julbouln/stm32_mech_keyboard/README

60% mechanichal keyboard with STM32 controller
