julbouln/stm32_mech_keyboard/hardware/README

Based on https://github.com/Ced67/TCKB_Kicad (https://deskthority.net/workshop-f7/tckb-my-journey-in-the-world-of-stm32-driven-keyboards-60-t14952.html)

Specifications:
- STM32 LQFP48 controller (tested with STM32F042)
- IS31FL3733 LED controller

Bugs/limitations
- USB-MINI B footprint is buggy, there is not solder pad on front layout
