julbouln/stm32_mech_keyboard/hardware/TCKB.kicad_pcb

## KiCad design hardware/TCKB.kicad_pcb (2017-02-14)

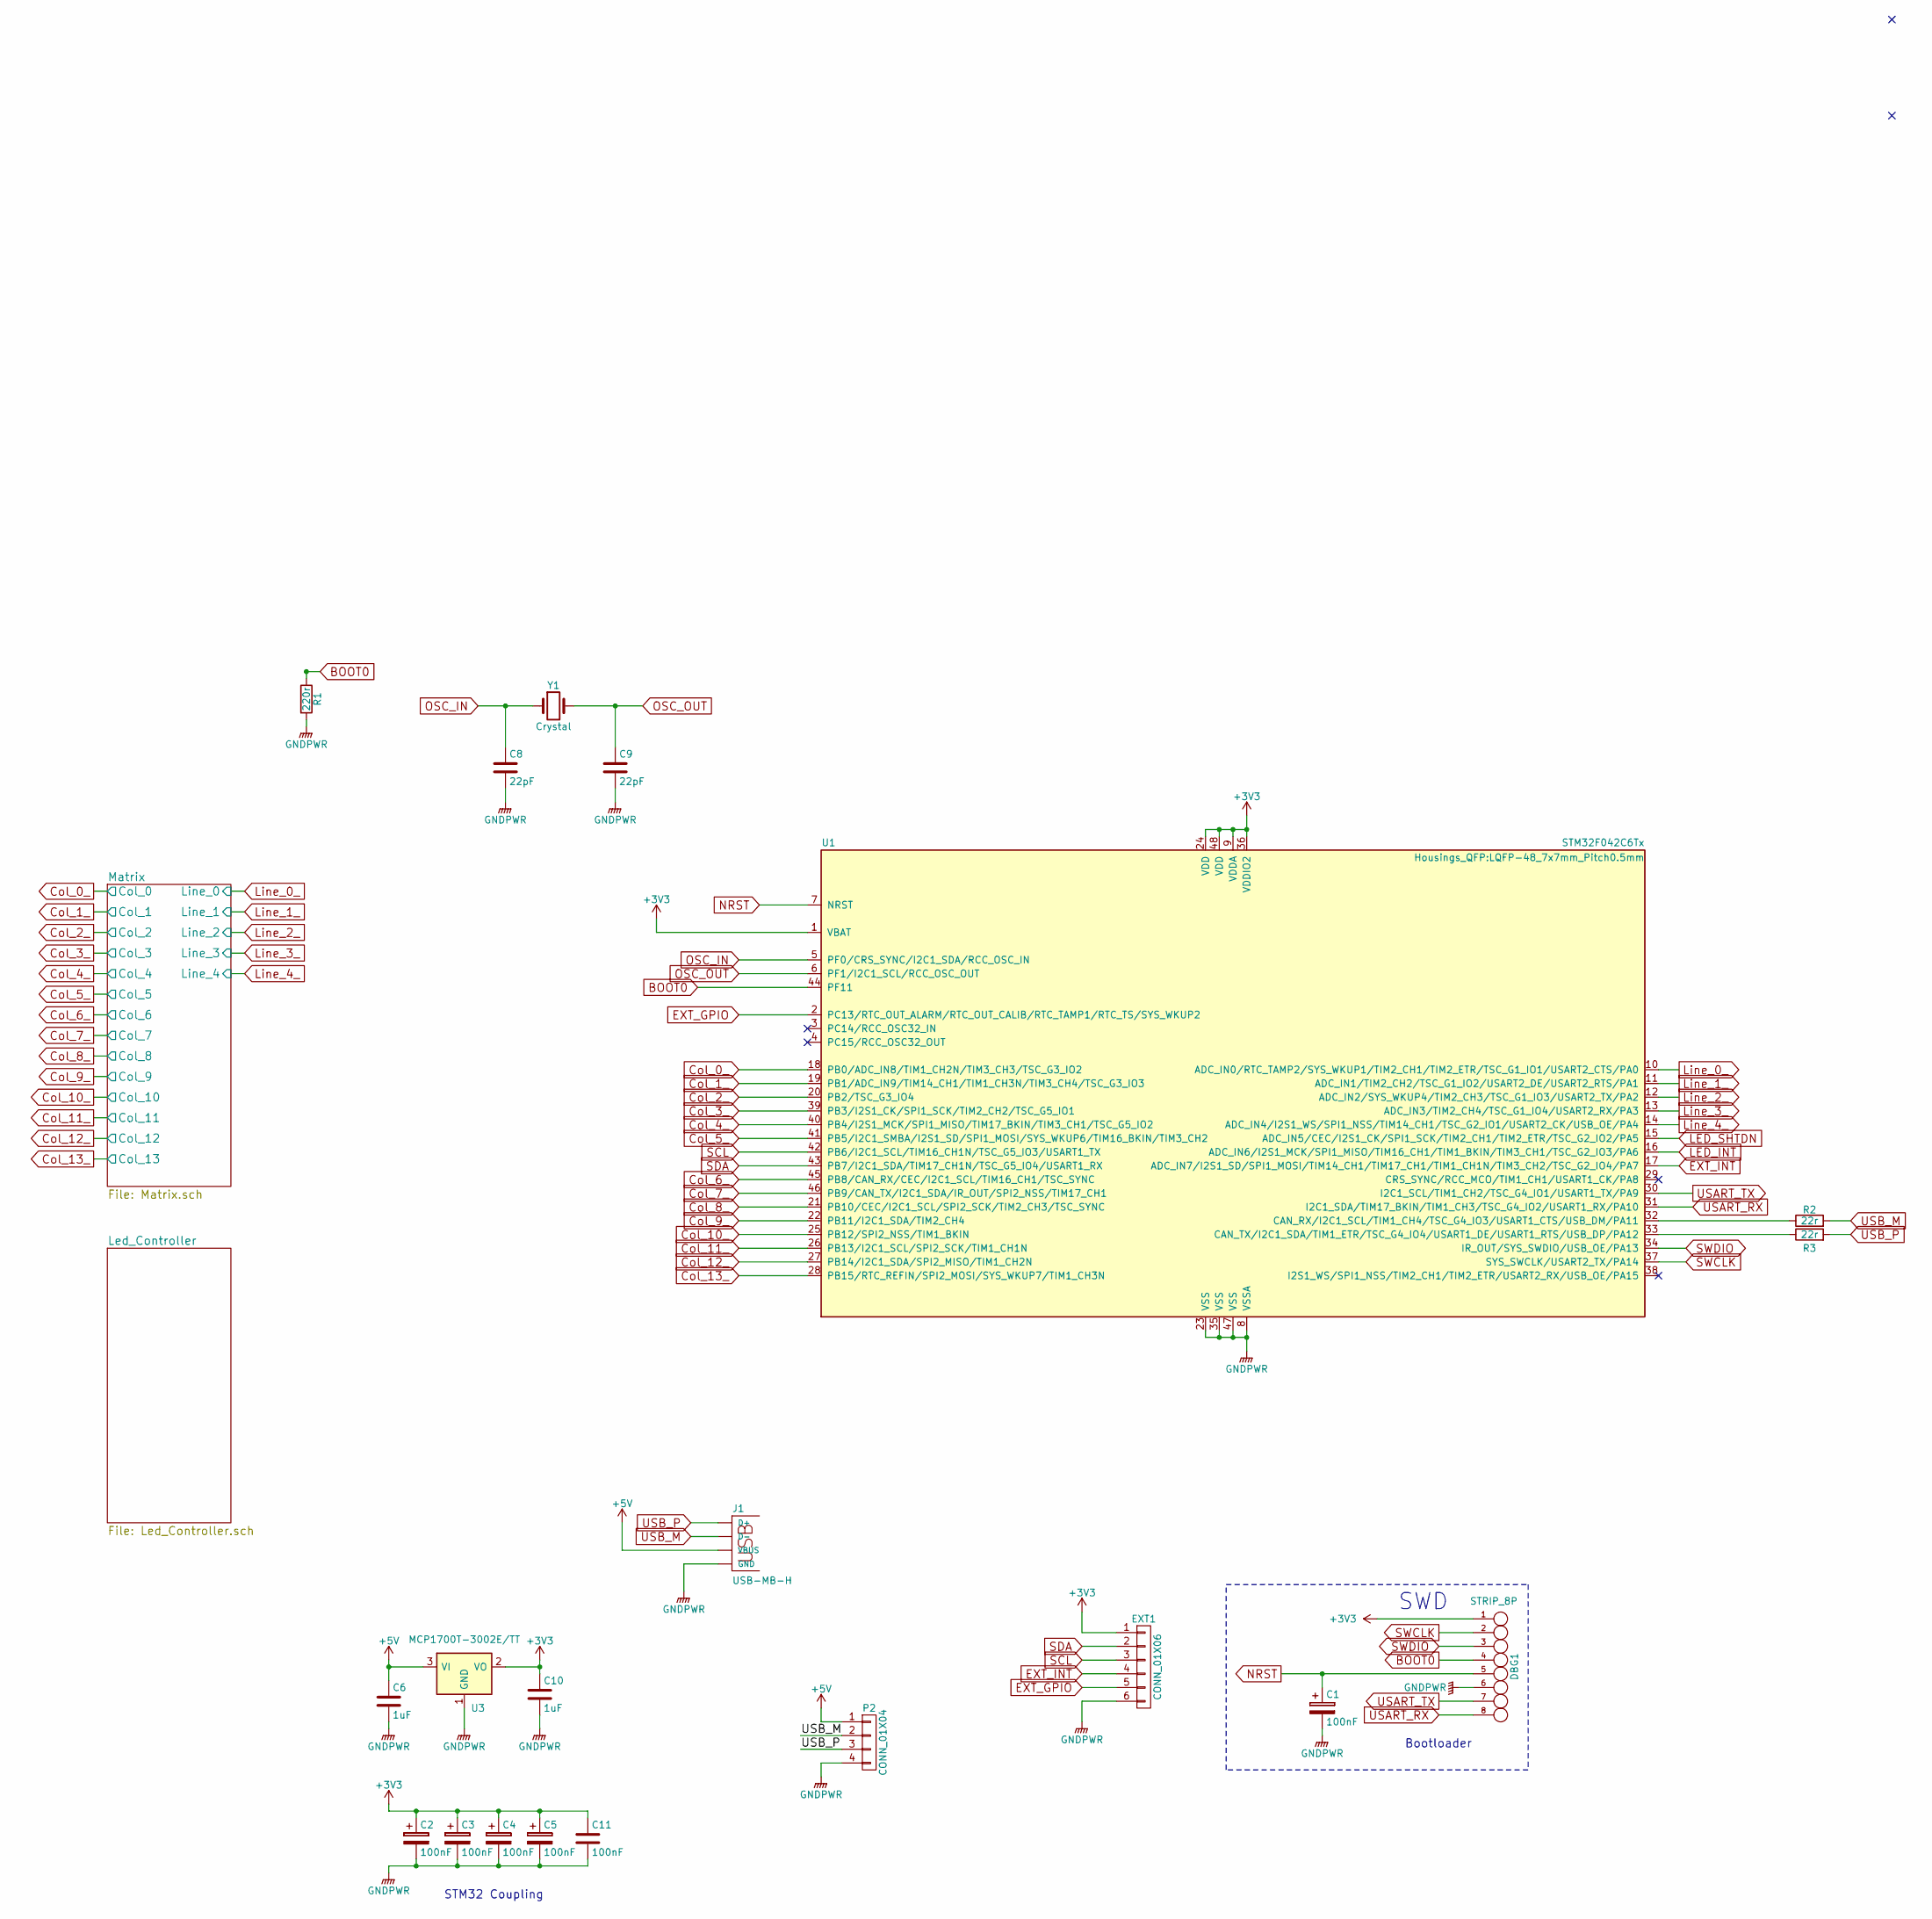
[picture p1: schematic TCKB.sch, TCKB :Tiny Custom KeyBoard (STM32L)]

Parts:
C1, C2, C3, C4, C5, C11: 100nF; C_0603_HandSoldering
C6, C10: 1uF; C_0603_HandSoldering
C8, C9: 22pF; C_0603_HandSoldering
DBG1: STRIP_8P; Pin_Header_Straight_1x08_Pitch2.54mm
EXT1: CONN_01X06; Pin_Header_Straight_1x06_Pitch2.54mm
J1: USB-MB-H
P2: CONN_01X04; Pin_Header_Straight_1x04_Pitch2.54mm
R1: 220r; R_0603_HandSoldering
R2, R3: 22r; R_0603_HandSoldering
U1: STM32F042C6Tx; LQFP-48_7x7mm_Pitch0.5mm
U3: MCP1700T-3002E/TT; SOT-23
Y1: Crystal; ABM3

Connections:
+3V3: C2.1, C3.1, C4.1, C5.1, C10.1, C11.1, DBG1.1, EXT1.1, U1.1 (VBAT), U1.9 (VDDA), U1.24 (VDD), U1.36 (VDDIO2), U1.48 (VDD), U3.2 (VO); also elsewhere on the board
+5V: C6.1, J1.VBUS, P2.1, U3.3 (VI); also elsewhere on the board
BOOT0: DBG1.4, R1.1, U1.44 (PF11)
Col_0_: U1.18 (PB0/ADC_IN8/TIM1_CH2N/TIM3_CH3/TSC_G3_I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); also elsewhere on the board
Col_1_: U1.19 (PB1/ADC_IN9/TIM14_CH1/TIM1_CH3N/TIM3_CH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); also elsewhere on the board
Col_2_: U1.20 (PB2/TSC_G3_IO4); also elsewhere on the board
Col_3_: U1.39 (PB3/I2S1_CK/SPI1_SCK/TIM2_CH2/TSC_G5_IO1); also elsewhere on the board
Col_4_: U1.40 (PB4/I2S1_MCK/SPI1_MISO/TIM17_BKIN/TIM3_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); also elsewhere on the board
Col_5_: U1.41 (PB5/I2C1_SMBA/I2S1_SD/SPI1_MOSI/SYS_WKU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); also elsewhere on the board
Col_6_: U1.45 (PB8/CAN_RX/CEC/I2C1_SCL/TIM16_CH1/TSC_S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); also elsewhere on the board
Col_7_: U1.46 (PB9/CAN_TX/I2C1_SDA/IR_OUT/SPI2_NSS/TIM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); also elsewhere on the board
Col_8_: U1.21 (PB10/CEC/I2C1_SCL/SPI2_SCK/TIM2_CH3/TSC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); also elsewhere on the board
Col_9_: U1.22 (PB11/I2C1_SDA/TIM2_CH4); also elsewhere on the board
Col_10_: U1.25 (PB12/SPI2_NSS/TIM1_BKIN); also elsewhere on the board
Col_11_: U1.26 (PB13/I2C1_SCL/SPI2_SCK/TIM1_CH1N); also elsewhere on the board
Col_12_: U1.27 (PB14/I2C1_SDA/SPI2_MISO/TIM1_CH2N); also elsewhere on the board
Col_13_: U1.28 (PB15/RTC_REFIN/SPI2_MOSI/SYS_WKUP7/TIM1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); also elsewhere on the board
EXT_GPIO: EXT1.5, U1.2 (PC13/RTC_OUT_ALARM/RTC_OUT_CALIB/RTC_TA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)
EXT_INT: EXT1.4, U1.17 (ADC_IN7/I2S1_SD/SPI1_MOSI/TIM14_CH1/TIM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)
GNDPWR: C1.2, C2.2, C3.2, C4.2, C5.2, C6.2, C8.2, C9.2, C10.2, C11.2, DBG1.6, EXT1.6, J1.GND, P2.4, R1.2, U1.8 (VSSA), U1.23 (VSS), U1.35 (VSS), U1.47 (VSS), U3.1 (GND); also elsewhere on the board
LED_INT: U1.16 (ADC_IN6/I2S1_MCK/SPI1_MISO/TIM16_CH1/TI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); also elsewhere on the board
LED_SHTDN: U1.15 (ADC_IN5/CEC/I2S1_CK/SPI1_SCK/TIM2_CH1/T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); also elsewhere on the board
Line_0_: U1.10 (ADC_IN0/RTC_TAMP2/SYS_WKUP1/TIM2_CH1/TI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); also elsewhere on the board
Line_1_: U1.11 (ADC_IN1/TIM2_CH2/TSC_G1_IO2/USART2_DE/U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); also elsewhere on the board
Line_2_: U1.12 (ADC_IN2/SYS_WKUP4/TIM2_CH3/TSC_G1_IO3/U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); also elsewhere on the board
Line_3_: U1.13 (ADC_IN3/TIM2_CH4/TSC_G1_IO4/USART2_RX/P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); also elsewhere on the board
Line_4_: U1.14 (ADC_IN4/I2S1_WS/SPI1_NSS/TIM14_CH1/TSC_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); also elsewhere on the board
NRST: C1.1, DBG1.5, U1.7 (NRST)
unnamed: R2.1, U1.32 (CAN_RX/I2C1_SCL/TIM1_CH4/TSC_G4_IO3/USA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)
unnamed: R3.1, U1.33 (CAN_TX/I2C1_SDA/TIM1_ETR/TSC_G4_IO4/USA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)
OSC_IN: C8.1, U1.5 (PF0/CRS_SYNC/I2C1_SDA/RCC_OSC_IN), Y1.1
OSC_OUT: C9.1, U1.6 (PF1/I2C1_SCL/RCC_OSC_OUT), Y1.2
SCL: EXT1.3, U1.42 (PB6/I2C1_SCL/TIM16_CH1N/TSC_G5_IO3/USAR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); also elsewhere on the board
SDA: EXT1.2, U1.43 (PB7/I2C1_SDA/TIM17_CH1N/TSC_G5_IO4/USAR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); also elsewhere on the board
SWCLK: DBG1.2, U1.37 (SYS_SWCLK/USART2_TX/PA14)
SWDIO: DBG1.3, U1.34 (IR_OUT/SYS_SWDIO/USB_OE/PA13)
USART_RX: DBG1.8, U1.31 (I2C1_SDA/TIM17_BKIN/TIM1_CH3/TSC_G4_IO2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)
USART_TX: DBG1.7, U1.30 (I2C1_SCL/TIM1_CH2/TSC_G4_IO1/USART1_TX/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)
USB_M: J1.D-, P2.2, R2.2
USB_P: J1.D+, P2.3, R3.2

Notes on the sheet:
SWD
STM32 Coupling
Bootloader

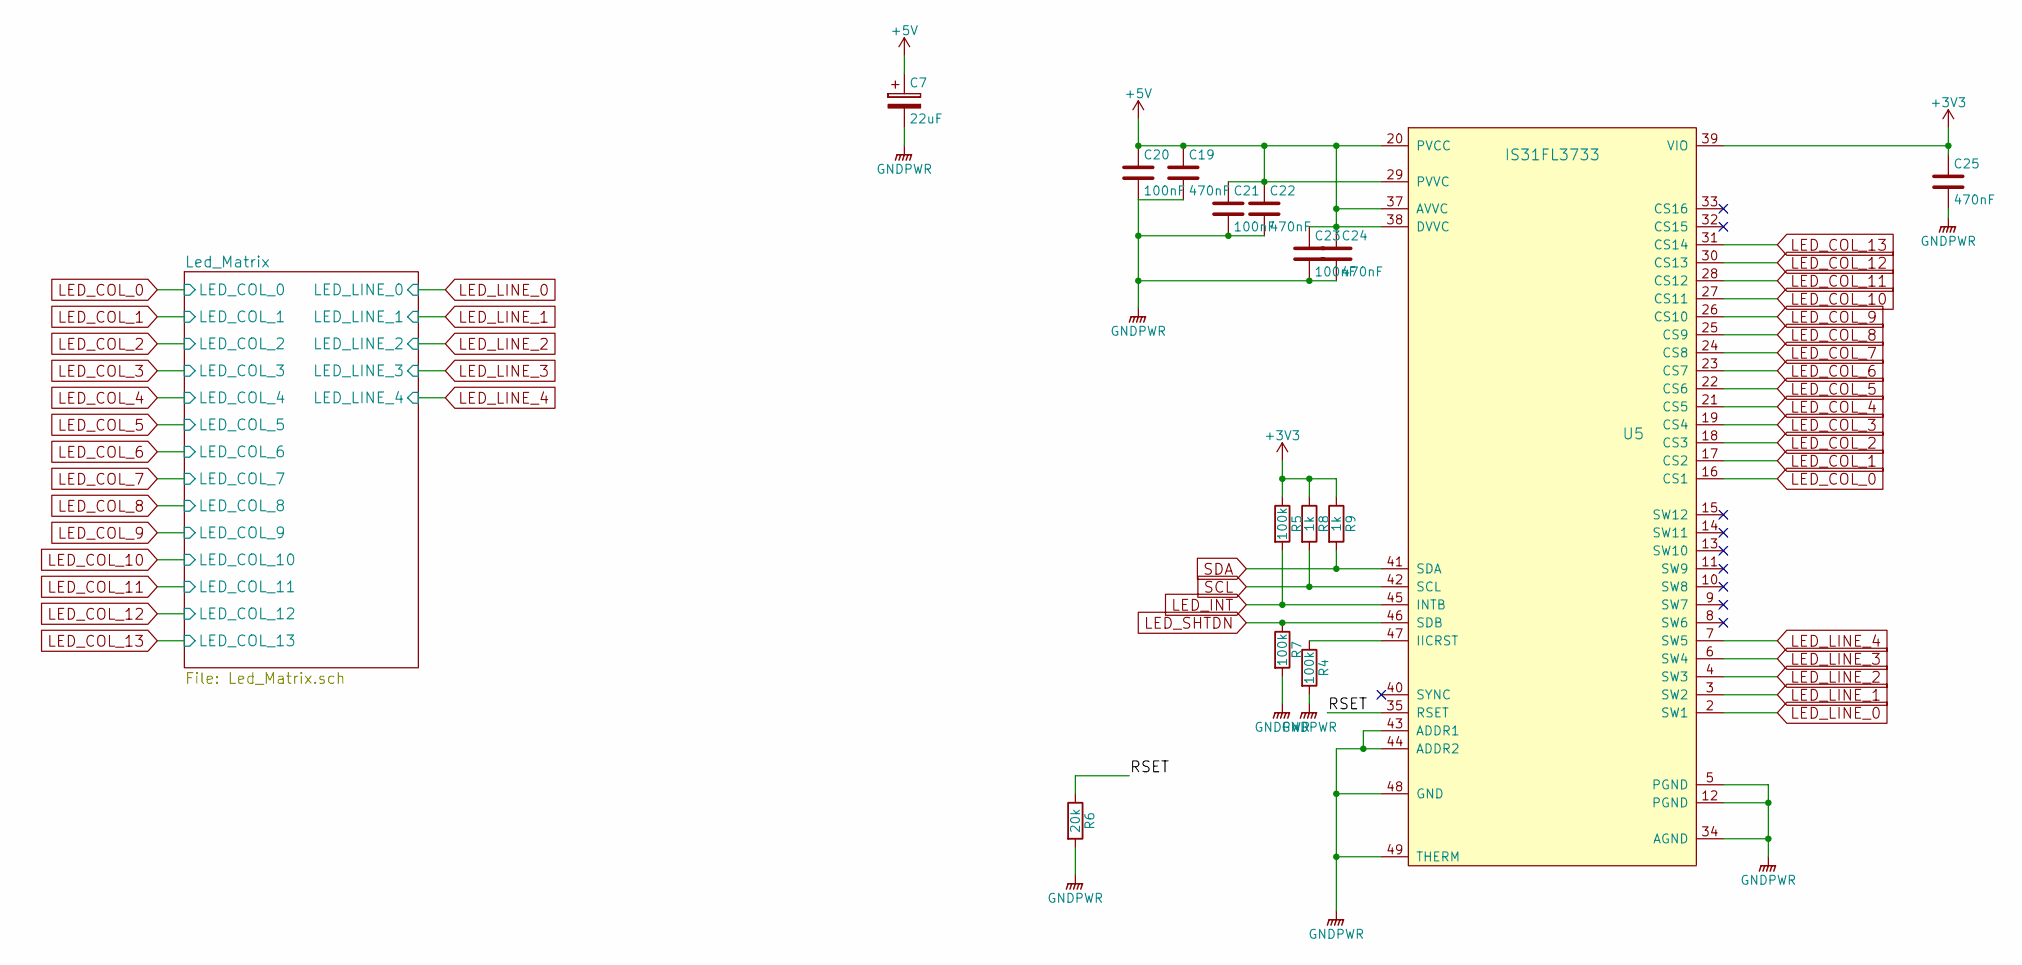
[picture p2: schematic Led_Controller.sch, TCKB :Tiny Custom KeyBoard (STM32L)]

Parts:
C7: 22uF; C_1206_HandSoldering
C19, C22, C24, C25: 470nF; C_0603_HandSoldering
C20, C21, C23: 100nF; C_0603_HandSoldering
R4, R5, R7: 100k; R_0603_HandSoldering
R6: 20k; R_0603_HandSoldering
R8, R9: 1k; R_0603_HandSoldering
U5: IS31FL3733; UQFN-48-1EP_6x6mm_Pitch0.4mm

Connections:
+3V3: C25.1, R5.1, R8.1, R9.1, U5.39 (VIO); also elsewhere on the board
+5V: C7.1, C19.1, C20.1, C21.1, C22.1, C23.1, C24.1, U5.20 (PVCC), U5.29 (PVVC), U5.37 (AVVC), U5.38 (DVVC); also elsewhere on the board
/Led_Controller/RSET: R6.1, U5.35 (RSET)
GNDPWR: C7.2, C19.2, C20.2, C21.2, C22.2, C23.2, C24.2, C25.2, R4.2, R6.2, R7.2, U5.5 (PGND), U5.12 (PGND), U5.34 (AGND), U5.43 (ADDR1), U5.44 (ADDR2), U5.48 (GND), U5.49 (THERM); also elsewhere on the board
LED_COL_0: U5.16 (CS1); also elsewhere on the board
LED_COL_1: U5.17 (CS2); also elsewhere on the board
LED_COL_2: U5.18 (CS3); also elsewhere on the board
LED_COL_3: U5.19 (CS4); also elsewhere on the board
LED_COL_4: U5.21 (CS5); also elsewhere on the board
LED_COL_5: U5.22 (CS6); also elsewhere on the board
LED_COL_6: U5.23 (CS7); also elsewhere on the board
LED_COL_7: U5.24 (CS8); also elsewhere on the board
LED_COL_8: U5.25 (CS9); also elsewhere on the board
LED_COL_9: U5.26 (CS10); also elsewhere on the board
LED_COL_10: U5.27 (CS11); also elsewhere on the board
LED_COL_11: U5.28 (CS12); also elsewhere on the board
LED_COL_12: U5.30 (CS13); also elsewhere on the board
LED_COL_13: U5.31 (CS14); also elsewhere on the board
LED_INT: R5.2, U5.45 (INTB); also elsewhere on the board
LED_LINE_0: U5.2 (SW1); also elsewhere on the board
LED_LINE_1: U5.3 (SW2); also elsewhere on the board
LED_LINE_2: U5.4 (SW3); also elsewhere on the board
LED_LINE_3: U5.6 (SW4); also elsewhere on the board
LED_LINE_4: U5.7 (SW5); also elsewhere on the board
LED_SHTDN: R7.1, U5.46 (SDB); also elsewhere on the board
unnamed: R4.1, U5.47 (IICRST)
SCL: R8.2, U5.42 (SCL); also elsewhere on the board
SDA: R9.2, U5.41 (SDA); also elsewhere on the board

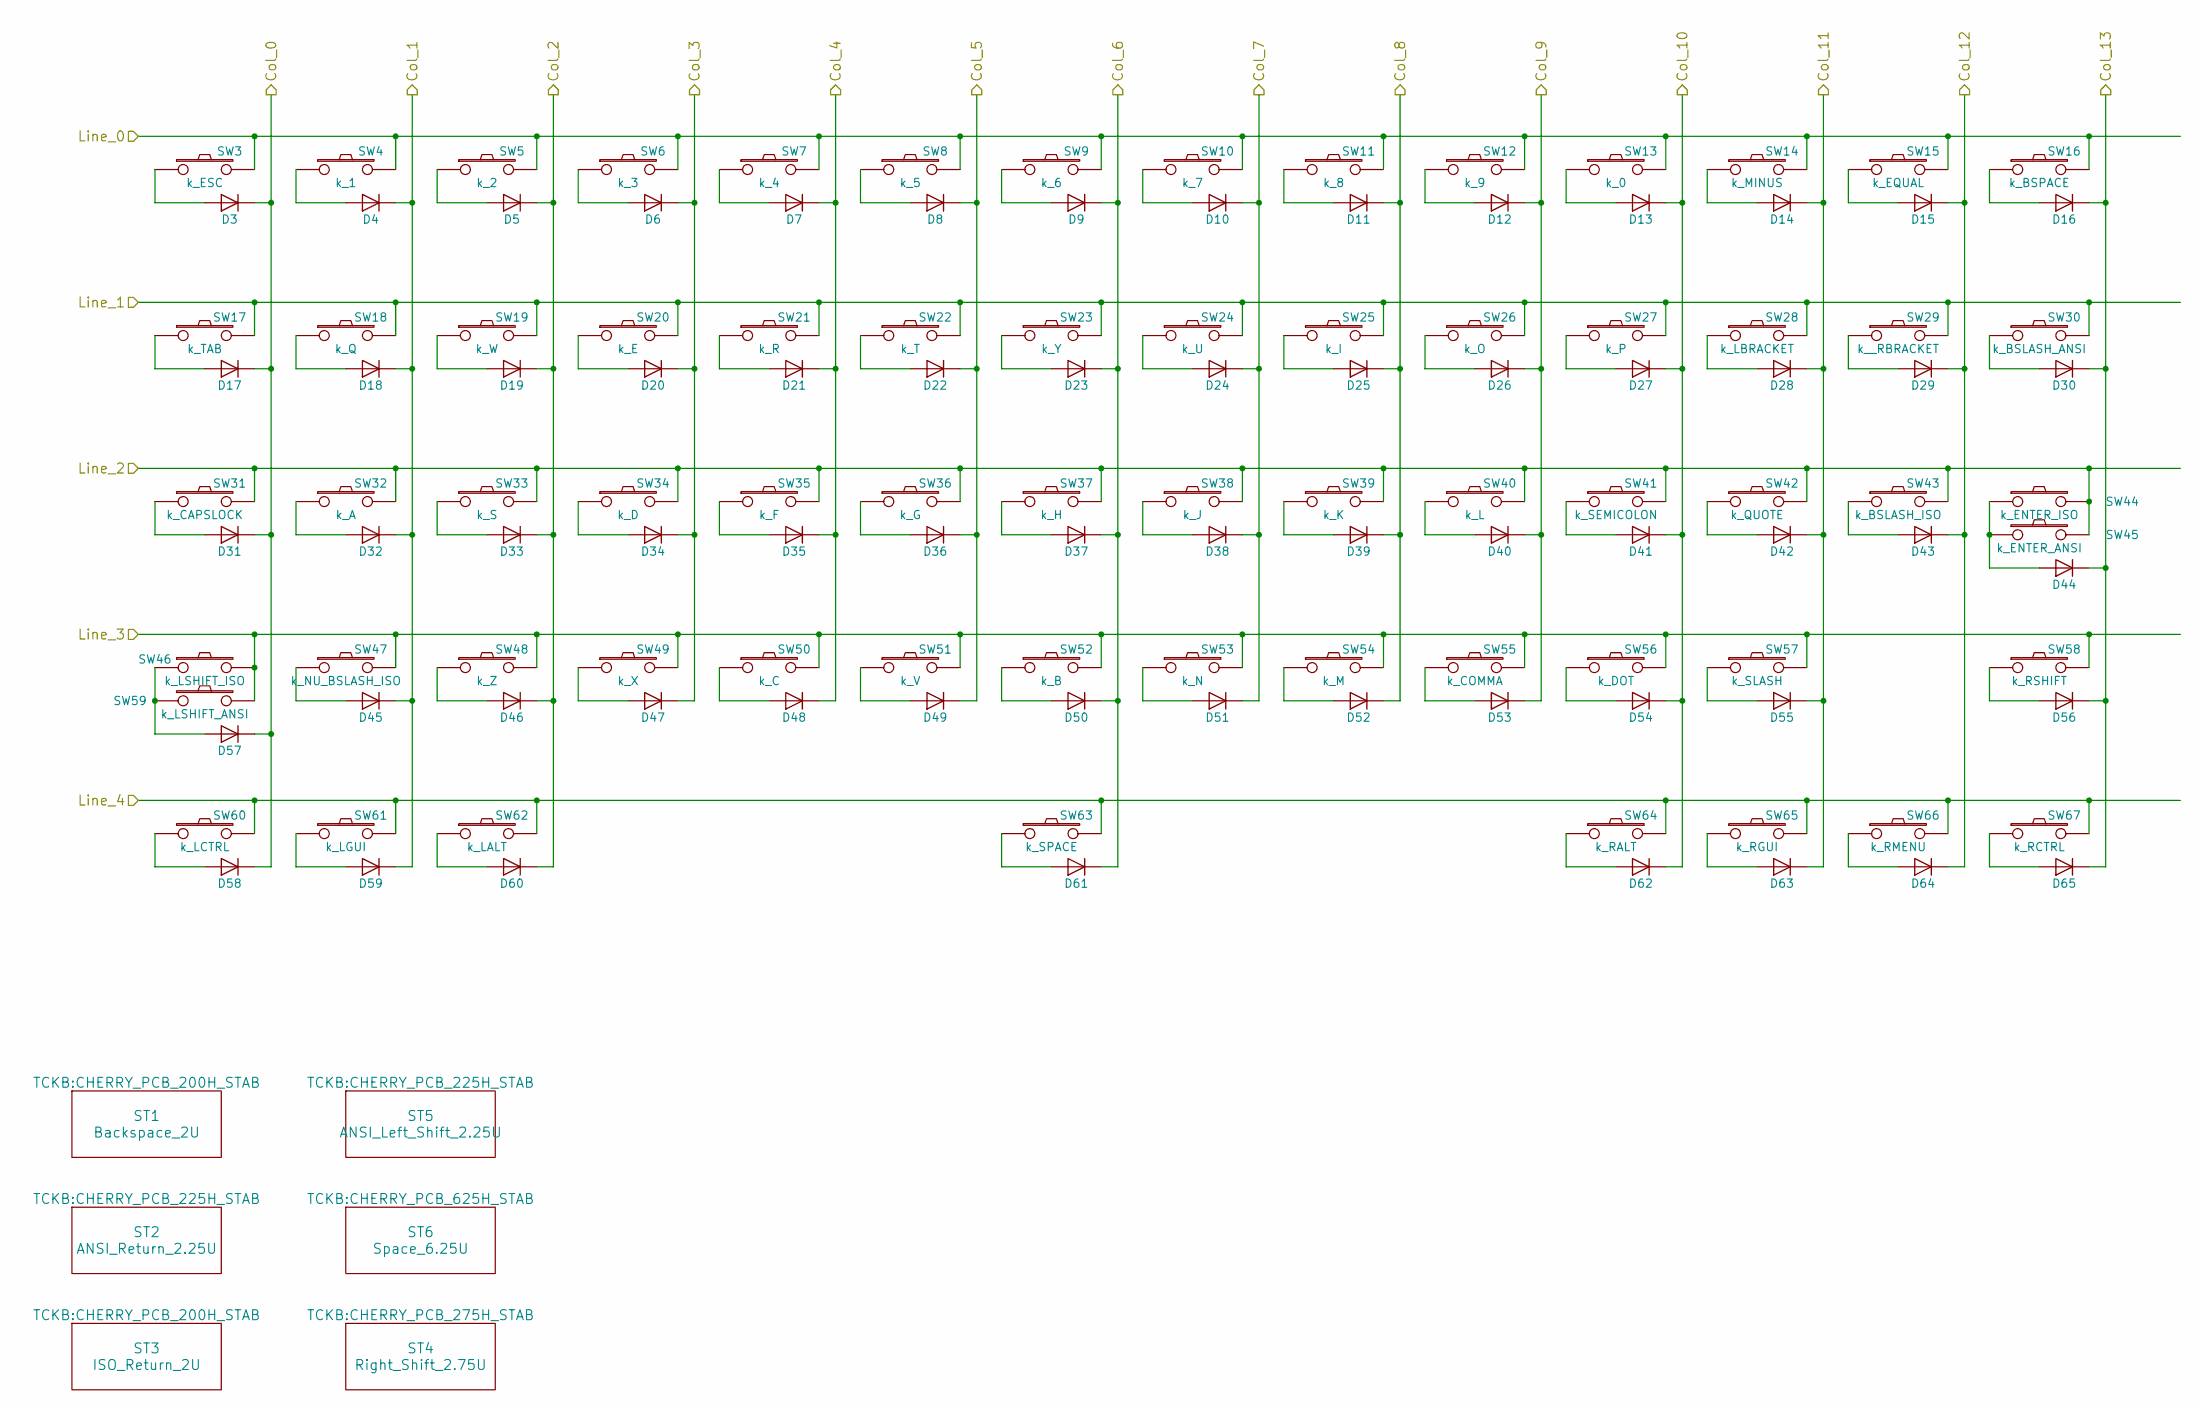
[picture p3: schematic Matrix.sch, TCKB :Tiny Custom KeyBoard (STM32L)]

Parts:
D3, D4, D5, D6, D7, D8, D9, D10, D11, D12, D13, D14, D15, D16, D17, D18, D19, D20, D21, D22, D23, D24, D25, D26, D27, D28, D29, D30, D31, D32, D33, D34, D35, D36, D37, D38, D39, D40, D41, D42, D43, D44, D45, D46, D47, D48, D49, D50, D51, D52, D53, D54, D55, D56, D57, D58, D59, D60, D61, D62, D63, D64, D65: 1N4148; MiniMELF_2mm
ST1: Backspace_2U; CHERRY_PCB_200H_STAB
ST2: ANSI_Return_2.25U; CHERRY_PCB_225H_STAB
ST3: ISO_Return_2U; CHERRY_PCB_200H_STAB
ST4: Right_Shift_2.75U; CHERRY_PCB_275H_STAB
ST5: ANSI_Left_Shift_2.25U; CHERRY_PCB_225H_STAB
ST6: Space_6.25U; CHERRY_PCB_625H_STAB
SW3: k_ESC; CHERRY_PCB_100H
SW4: k_1; CHERRY_PCB_100H
SW5: k_2; CHERRY_PCB_100H
SW6: k_3; CHERRY_PCB_100H
SW7: k_4; CHERRY_PCB_100H
SW8: k_5; CHERRY_PCB_100H
SW9: k_6; CHERRY_PCB_100H
SW10: k_7; CHERRY_PCB_100H
SW11: k_8; CHERRY_PCB_100H
SW12: k_9; CHERRY_PCB_100H
SW13: k_0; CHERRY_PCB_100H
SW14: k_MINUS; CHERRY_PCB_100H
SW15: k_EQUAL; CHERRY_PCB_100H
SW16: k_BSPACE; CHERRY_PCB_200H_SW
SW17: k_TAB; CHERRY_PCB_150H
SW18: k_Q; CHERRY_PCB_100H
SW19: k_W; CHERRY_PCB_100H
SW20: k_E; CHERRY_PCB_100H
SW21: k_R; CHERRY_PCB_100H
SW22: k_T; CHERRY_PCB_100H
SW23: k_Y; CHERRY_PCB_100H
SW24: k_U; CHERRY_PCB_100H
SW25: k_I; CHERRY_PCB_100H
SW26: k_O; CHERRY_PCB_100H
SW27: k_P; CHERRY_PCB_100H
SW28: k_LBRACKET; CHERRY_PCB_100H
SW29: k__RBRACKET; CHERRY_PCB_100H
SW30: k_BSLASH_ANSI; CHERRY_PCB_150H
SW31: k_CAPSLOCK; CHERRY_PCB_175H
SW32: k_A; CHERRY_PCB_100H
SW33: k_S; CHERRY_PCB_100H
SW34: k_D; CHERRY_PCB_100H
SW35: k_F; CHERRY_PCB_100H
SW36: k_G; CHERRY_PCB_100H
SW37: k_H; CHERRY_PCB_100H
SW38: k_J; CHERRY_PCB_100H
SW39: k_K; CHERRY_PCB_100H
SW40: k_L; CHERRY_PCB_100H
SW41: k_SEMICOLON; CHERRY_PCB_100H
SW42: k_QUOTE; CHERRY_PCB_100H
SW43: k_BSLASH_ISO; CHERRY_PCB_100H
SW44: k_ENTER_ISO; CHERRY_PCB_200H_SW
SW45: k_ENTER_ANSI; CHERRY_PCB_225H_SW
SW46: k_LSHIFT_ISO; CHERRY_PCB_125H
SW47: k_NU_BSLASH_ISO; CHERRY_PCB_100H
SW48: k_Z; CHERRY_PCB_100H
SW49: k_X; CHERRY_PCB_100H
SW50: k_C; CHERRY_PCB_100H
SW51: k_V; CHERRY_PCB_100H
SW52: k_B; CHERRY_PCB_100H
SW53: k_N; CHERRY_PCB_100H
SW54: k_M; CHERRY_PCB_100H
SW55: k_COMMA; CHERRY_PCB_100H
SW56: k_DOT; CHERRY_PCB_100H
SW57: k_SLASH; CHERRY_PCB_100H
SW58: k_RSHIFT; CHERRY_PCB_275H_SW
SW59: k_LSHIFT_ANSI; CHERRY_PCB_225H_SW
SW60: k_LCTRL; CHERRY_PCB_125H
SW61: k_LGUI; CHERRY_PCB_125H
SW62: k_LALT; CHERRY_PCB_125H
SW63: k_SPACE; CHERRY_PCB_625H_SW
SW64: k_RALT; CHERRY_PCB_125H
SW65: k_RGUI; CHERRY_PCB_125H
SW66: k_RMENU; CHERRY_PCB_125H
SW67: k_RCTRL; CHERRY_PCB_125H

Connections:
Col_0_: D3.1 (K), D17.1 (K), D31.1 (K), D57.1 (K), D58.1 (K); also elsewhere on the board
Col_1_: D4.1 (K), D18.1 (K), D32.1 (K), D45.1 (K), D59.1 (K); also elsewhere on the board
Col_2_: D5.1 (K), D19.1 (K), D33.1 (K), D46.1 (K), D60.1 (K); also elsewhere on the board
Col_3_: D6.1 (K), D20.1 (K), D34.1 (K), D47.1 (K); also elsewhere on the board
Col_4_: D7.1 (K), D21.1 (K), D35.1 (K), D48.1 (K); also elsewhere on the board
Col_5_: D8.1 (K), D22.1 (K), D36.1 (K), D49.1 (K); also elsewhere on the board
Col_6_: D9.1 (K), D23.1 (K), D37.1 (K), D50.1 (K), D61.1 (K); also elsewhere on the board
Col_7_: D10.1 (K), D24.1 (K), D38.1 (K), D51.1 (K); also elsewhere on the board
Col_8_: D11.1 (K), D25.1 (K), D39.1 (K), D52.1 (K); also elsewhere on the board
Col_9_: D12.1 (K), D26.1 (K), D40.1 (K), D53.1 (K); also elsewhere on the board
Col_10_: D13.1 (K), D27.1 (K), D41.1 (K), D54.1 (K), D62.1 (K); also elsewhere on the board
Col_11_: D14.1 (K), D28.1 (K), D42.1 (K), D55.1 (K), D63.1 (K); also elsewhere on the board
Col_12_: D15.1 (K), D29.1 (K), D43.1 (K), D64.1 (K); also elsewhere on the board
Col_13_: D16.1 (K), D30.1 (K), D44.1 (K), D56.1 (K), D65.1 (K); also elsewhere on the board
Line_0_: SW3.2, SW4.2, SW5.2, SW6.2, SW7.2, SW8.2, SW9.2, SW10.2, SW11.2, SW12.2, SW13.2, SW14.2, SW15.2, SW16.2; also elsewhere on the board
Line_1_: SW17.2, SW18.2, SW19.2, SW20.2, SW21.2, SW22.2, SW23.2, SW24.2, SW25.2, SW26.2, SW27.2, SW28.2, SW29.2, SW30.2; also elsewhere on the board
Line_2_: SW31.2, SW32.2, SW33.2, SW34.2, SW35.2, SW36.2, SW37.2, SW38.2, SW39.2, SW40.2, SW41.2, SW42.2, SW43.2, SW44.2, SW45.2; also elsewhere on the board
Line_3_: SW46.2, SW47.2, SW48.2, SW49.2, SW50.2, SW51.2, SW52.2, SW53.2, SW54.2, SW55.2, SW56.2, SW57.2, SW58.2, SW59.2; also elsewhere on the board
Line_4_: SW60.2, SW61.2, SW62.2, SW63.2, SW64.2, SW65.2, SW66.2, SW67.2; also elsewhere on the board
unnamed: D3.2 (A), SW3.1
unnamed: D4.2 (A), SW4.1
unnamed: D5.2 (A), SW5.1
unnamed: D6.2 (A), SW6.1
unnamed: D7.2 (A), SW7.1
unnamed: D8.2 (A), SW8.1
unnamed: D9.2 (A), SW9.1
unnamed: D10.2 (A), SW10.1
unnamed: D11.2 (A), SW11.1
unnamed: D12.2 (A), SW12.1
unnamed: D13.2 (A), SW13.1
unnamed: D14.2 (A), SW14.1
unnamed: D15.2 (A), SW15.1
unnamed: D16.2 (A), SW16.1
unnamed: D17.2 (A), SW17.1
unnamed: D18.2 (A), SW18.1
unnamed: D19.2 (A), SW19.1
unnamed: D20.2 (A), SW20.1
unnamed: D21.2 (A), SW21.1
unnamed: D22.2 (A), SW22.1
unnamed: D23.2 (A), SW23.1
unnamed: D24.2 (A), SW24.1
unnamed: D25.2 (A), SW25.1
unnamed: D26.2 (A), SW26.1
unnamed: D27.2 (A), SW27.1
unnamed: D28.2 (A), SW28.1
unnamed: D29.2 (A), SW29.1
unnamed: D30.2 (A), SW30.1
unnamed: D31.2 (A), SW31.1
unnamed: D32.2 (A), SW32.1
unnamed: D33.2 (A), SW33.1
unnamed: D34.2 (A), SW34.1
unnamed: D35.2 (A), SW35.1
unnamed: D36.2 (A), SW36.1
unnamed: D37.2 (A), SW37.1
unnamed: D38.2 (A), SW38.1
unnamed: D39.2 (A), SW39.1
unnamed: D40.2 (A), SW40.1
unnamed: D41.2 (A), SW41.1
unnamed: D42.2 (A), SW42.1
unnamed: D43.2 (A), SW43.1
unnamed: D44.2 (A), SW44.1, SW45.1
unnamed: D45.2 (A), SW47.1
unnamed: D46.2 (A), SW48.1
unnamed: D47.2 (A), SW49.1
unnamed: D48.2 (A), SW50.1
unnamed: D49.2 (A), SW51.1
unnamed: D50.2 (A), SW52.1
unnamed: D51.2 (A), SW53.1
unnamed: D52.2 (A), SW54.1
unnamed: D53.2 (A), SW55.1
unnamed: D54.2 (A), SW56.1
unnamed: D55.2 (A), SW57.1
unnamed: D56.2 (A), SW58.1
unnamed: D57.2 (A), SW46.1, SW59.1
unnamed: D58.2 (A), SW60.1
unnamed: D59.2 (A), SW61.1
unnamed: D60.2 (A), SW62.1
unnamed: D61.2 (A), SW63.1
unnamed: D62.2 (A), SW64.1
unnamed: D63.2 (A), SW65.1
unnamed: D64.2 (A), SW66.1
unnamed: D65.2 (A), SW67.1

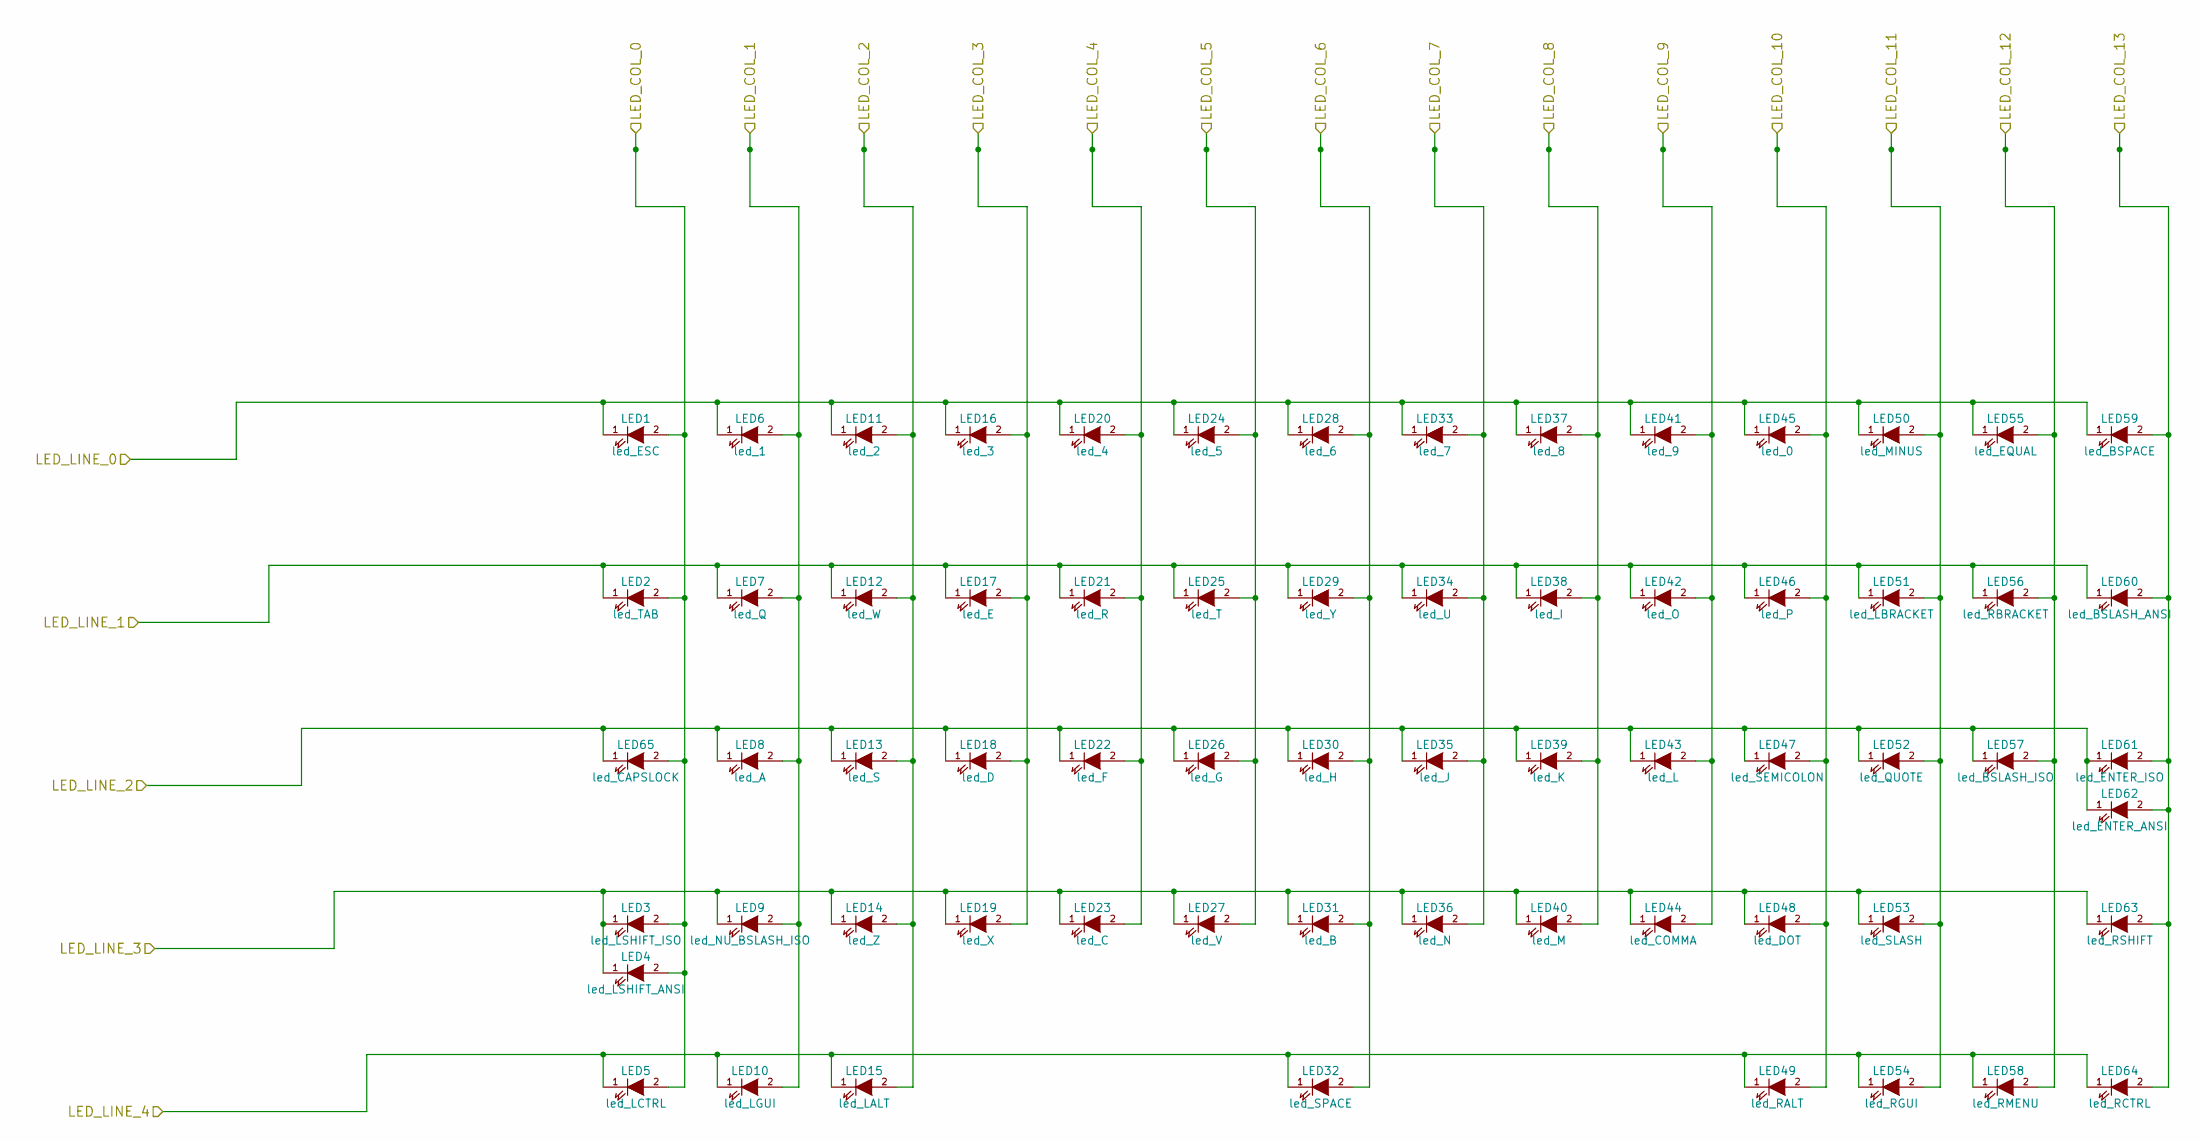
[picture p4: schematic Led_Matrix.sch, TCKB :Tiny Custom KeyBoard (STM32L)]

Parts:
LED1: led_ESC; CHERRY_MX_LED
LED2: led_TAB; CHERRY_MX_LED
LED3: led_LSHIFT_ISO; CHERRY_MX_LED
LED4: led_LSHIFT_ANSI; CHERRY_MX_LED
LED5: led_LCTRL; CHERRY_MX_LED
LED6: led_1; CHERRY_MX_LED
LED7: led_Q; CHERRY_MX_LED
LED8: led_A; CHERRY_MX_LED
LED9: led_NU_BSLASH_ISO; CHERRY_MX_LED
LED10: led_LGUI; CHERRY_MX_LED
LED11: led_2; CHERRY_MX_LED
LED12: led_W; CHERRY_MX_LED
LED13: led_S; CHERRY_MX_LED
LED14: led_Z; CHERRY_MX_LED
LED15: led_LALT; CHERRY_MX_LED
LED16: led_3; CHERRY_MX_LED
LED17: led_E; CHERRY_MX_LED
LED18: led_D; CHERRY_MX_LED
LED19: led_X; CHERRY_MX_LED
LED20: led_4; CHERRY_MX_LED
LED21: led_R; CHERRY_MX_LED
LED22: led_F; CHERRY_MX_LED
LED23: led_C; CHERRY_MX_LED
LED24: led_5; CHERRY_MX_LED
LED25: led_T; CHERRY_MX_LED
LED26: led_G; CHERRY_MX_LED
LED27: led_V; CHERRY_MX_LED
LED28: led_6; CHERRY_MX_LED
LED29: led_Y; CHERRY_MX_LED
LED30: led_H; CHERRY_MX_LED
LED31: led_B; CHERRY_MX_LED
LED32: led_SPACE; CHERRY_MX_LED
LED33: led_7; CHERRY_MX_LED
LED34: led_U; CHERRY_MX_LED
LED35: led_J; CHERRY_MX_LED
LED36: led_N; CHERRY_MX_LED
LED37: led_8; CHERRY_MX_LED
LED38: led_I; CHERRY_MX_LED
LED39: led_K; CHERRY_MX_LED
LED40: led_M; CHERRY_MX_LED
LED41: led_9; CHERRY_MX_LED
LED42: led_O; CHERRY_MX_LED
LED43: led_L; CHERRY_MX_LED
LED44: led_COMMA; CHERRY_MX_LED
LED45: led_0; CHERRY_MX_LED
LED46: led_P; CHERRY_MX_LED
LED47: led_SEMICOLON; CHERRY_MX_LED
LED48: led_DOT; CHERRY_MX_LED
LED49: led_RALT; CHERRY_MX_LED
LED50: led_MINUS; CHERRY_MX_LED
LED51: led_LBRACKET; CHERRY_MX_LED
LED52: led_QUOTE; CHERRY_MX_LED
LED53: led_SLASH; CHERRY_MX_LED
LED54: led_RGUI; CHERRY_MX_LED
LED55: led_EQUAL; CHERRY_MX_LED
LED56: led_RBRACKET; CHERRY_MX_LED
LED57: led_BSLASH_ISO; CHERRY_MX_LED
LED58: led_RMENU; CHERRY_MX_LED
LED59: led_BSPACE; CHERRY_MX_LED
LED60: led_BSLASH_ANSI; CHERRY_MX_LED
LED61: led_ENTER_ISO; CHERRY_MX_LED
LED62: led_ENTER_ANSI; CHERRY_MX_LED
LED63: led_RSHIFT; CHERRY_MX_LED
LED64: led_RCTRL; CHERRY_MX_LED
LED65: led_CAPSLOCK; CHERRY_MX_LED

Connections:
LED_COL_0: LED1.2 (A), LED2.2 (A), LED3.2 (A), LED4.2 (A), LED5.2 (A), LED65.2 (A); also elsewhere on the board
LED_COL_1: LED6.2 (A), LED7.2 (A), LED8.2 (A), LED9.2 (A), LED10.2 (A); also elsewhere on the board
LED_COL_2: LED11.2 (A), LED12.2 (A), LED13.2 (A), LED14.2 (A), LED15.2 (A); also elsewhere on the board
LED_COL_3: LED16.2 (A), LED17.2 (A), LED18.2 (A), LED19.2 (A); also elsewhere on the board
LED_COL_4: LED20.2 (A), LED21.2 (A), LED22.2 (A), LED23.2 (A); also elsewhere on the board
LED_COL_5: LED24.2 (A), LED25.2 (A), LED26.2 (A), LED27.2 (A); also elsewhere on the board
LED_COL_6: LED28.2 (A), LED29.2 (A), LED30.2 (A), LED31.2 (A), LED32.2 (A); also elsewhere on the board
LED_COL_7: LED33.2 (A), LED34.2 (A), LED35.2 (A), LED36.2 (A); also elsewhere on the board
LED_COL_8: LED37.2 (A), LED38.2 (A), LED39.2 (A), LED40.2 (A); also elsewhere on the board
LED_COL_9: LED41.2 (A), LED42.2 (A), LED43.2 (A), LED44.2 (A); also elsewhere on the board
LED_COL_10: LED45.2 (A), LED46.2 (A), LED47.2 (A), LED48.2 (A), LED49.2 (A); also elsewhere on the board
LED_COL_11: LED50.2 (A), LED51.2 (A), LED52.2 (A), LED53.2 (A), LED54.2 (A); also elsewhere on the board
LED_COL_12: LED55.2 (A), LED56.2 (A), LED57.2 (A), LED58.2 (A); also elsewhere on the board
LED_COL_13: LED59.2 (A), LED60.2 (A), LED61.2 (A), LED62.2 (A), LED63.2 (A), LED64.2 (A); also elsewhere on the board
LED_LINE_0: LED1.1 (K), LED6.1 (K), LED11.1 (K), LED16.1 (K), LED20.1 (K), LED24.1 (K), LED28.1 (K), LED33.1 (K), LED37.1 (K), LED41.1 (K), LED45.1 (K), LED50.1 (K), LED55.1 (K), LED59.1 (K); also elsewhere on the board
LED_LINE_1: LED2.1 (K), LED7.1 (K), LED12.1 (K), LED17.1 (K), LED21.1 (K), LED25.1 (K), LED29.1 (K), LED34.1 (K), LED38.1 (K), LED42.1 (K), LED46.1 (K), LED51.1 (K), LED56.1 (K), LED60.1 (K); also elsewhere on the board
LED_LINE_2: LED8.1 (K), LED13.1 (K), LED18.1 (K), LED22.1 (K), LED26.1 (K), LED30.1 (K), LED35.1 (K), LED39.1 (K), LED43.1 (K), LED47.1 (K), LED52.1 (K), LED57.1 (K), LED61.1 (K), LED62.1 (K), LED65.1 (K); also elsewhere on the board
LED_LINE_3: LED3.1 (K), LED4.1 (K), LED9.1 (K), LED14.1 (K), LED19.1 (K), LED23.1 (K), LED27.1 (K), LED31.1 (K), LED36.1 (K), LED40.1 (K), LED44.1 (K), LED48.1 (K), LED53.1 (K), LED63.1 (K); also elsewhere on the board
LED_LINE_4: LED5.1 (K), LED10.1 (K), LED15.1 (K), LED32.1 (K), LED49.1 (K), LED54.1 (K), LED58.1 (K), LED64.1 (K); also elsewhere on the board
