julbouln/stm32_mech_keyboard/hardware/TCKB.kicad_pcb

## KiCad design hardware/TCKB.kicad_pcb (continued)

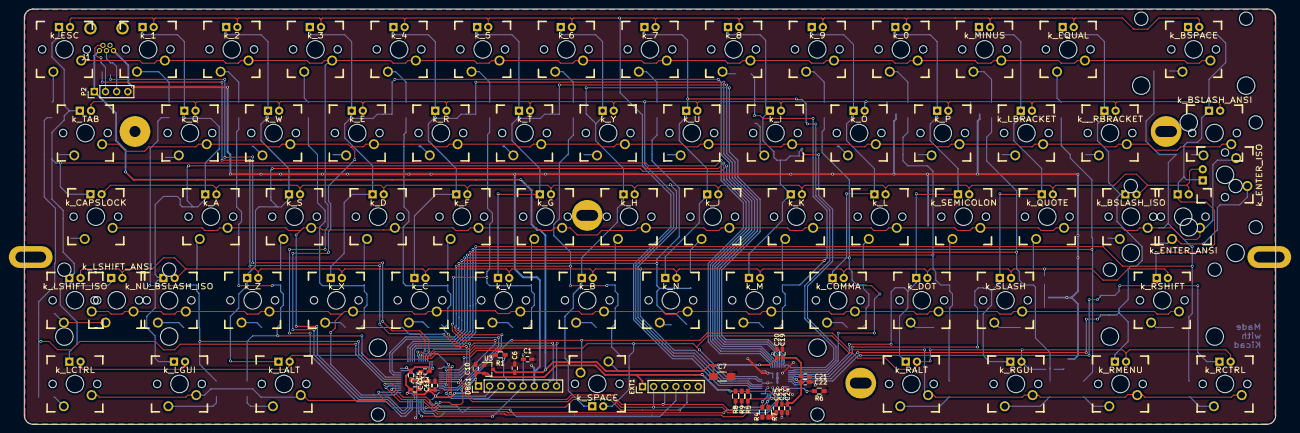
[picture p5: board TCKB.kicad_pcb from above]

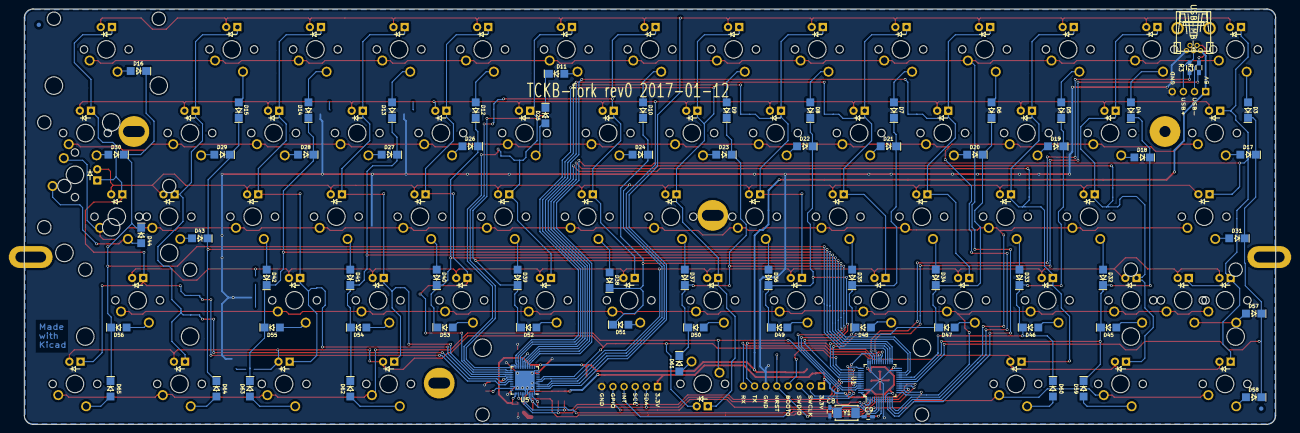
[picture p6: board TCKB.kicad_pcb from below]

Board: 2 copper layers, 285.0 x 94.6 mm, 242 parts (74 on the bottom side), 124 nets.

Other parts of the board:
FID: FIDUCIAL
FID#2: FIDUCIAL
HOLE: VAL**; PKRHSL
HOLE#2: VAL**; PKRHSL
HOLE#3, HOLE#4, HOLE#5: VAL**; PKRH
HOLE#6: VAL**; PKRHC
