julbouln/stm32_mech_keyboard/(notices)

Notices in the files:
firmware/keyboard.h:
This library is free software: you can redistribute it and/or modify it under
the terms of the GNU General Public License as published by the Free Software
